zanebeeai/WarRig/self-driving (eBurb POC)/zane_self_driving_car_report.pdf

Making a car, then avoiding driving it.

Zane Beeai

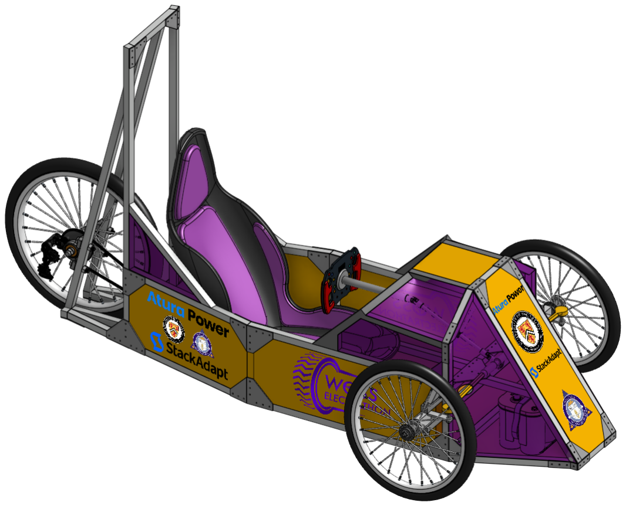
[picture p3: figure]

June 12, 2025

Z. Beeai | Full-scale self-driving EV | June 12, 2025 | 1 / 32

## Outline

1 | Introduction
2 | Frame Design
3 | Front Drivetrain
4 | Rear Drivetrain
5 | Electrical System
6 | Autonomy System
Z. Beeai | Full-scale self-driving EV | June 12, 2025 | 2 / 32

## Our Ethos

Minimalist Engineering: simplicity, manufacturability, robustness. Quantitative modeling: FEA, drivetrain & electrical analysis. Subsystem-based design philosophy.

Z. Beeai | Full-scale self-driving EV | June 12, 2025 | 3 / 32

## Design Objectives

Simplicity Across Subsystems

DFMA for Manual Tools
Subsystem Modularity
Numerical Justification via Simulation Electrical Redundancy (telemetry, safeguards)
Z. Beeai | Full-scale self-driving EV | June 12, 2025 | 4 / 32

## Material Selection

Aluminum offered ˜74% mass reduction compared to steel while maintaining safety margins validated by FEA.

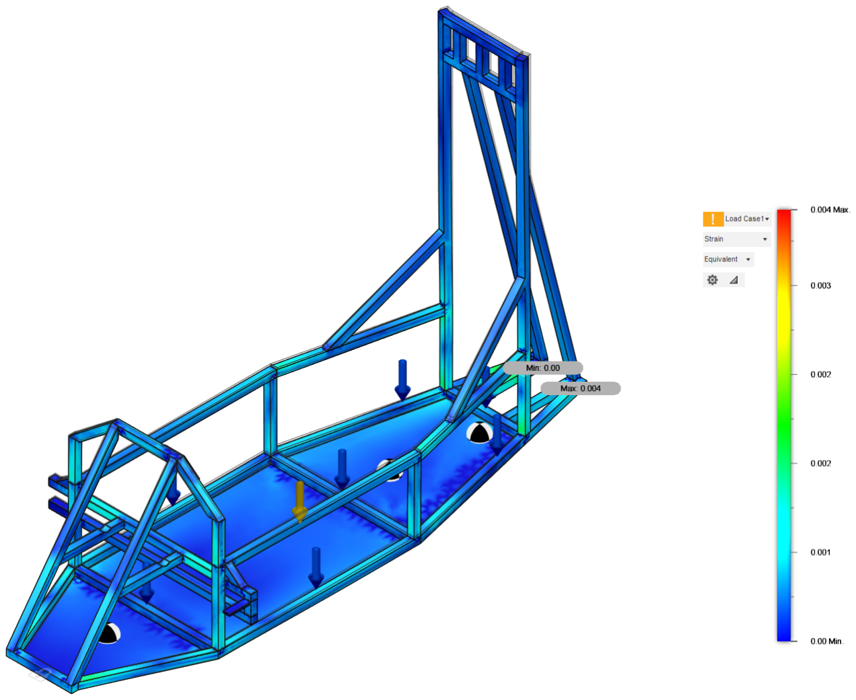
[picture p4: figure]

Figure: Figure 1: Frame FEA under 10,000 N load.

Z. Beeai | Full-scale self-driving EV | June 12, 2025 | 5 / 32

## Hybrid Assembly

Structural gussets combined with bolts, rivets, and TIG welding reinforced load paths at critical junctions.

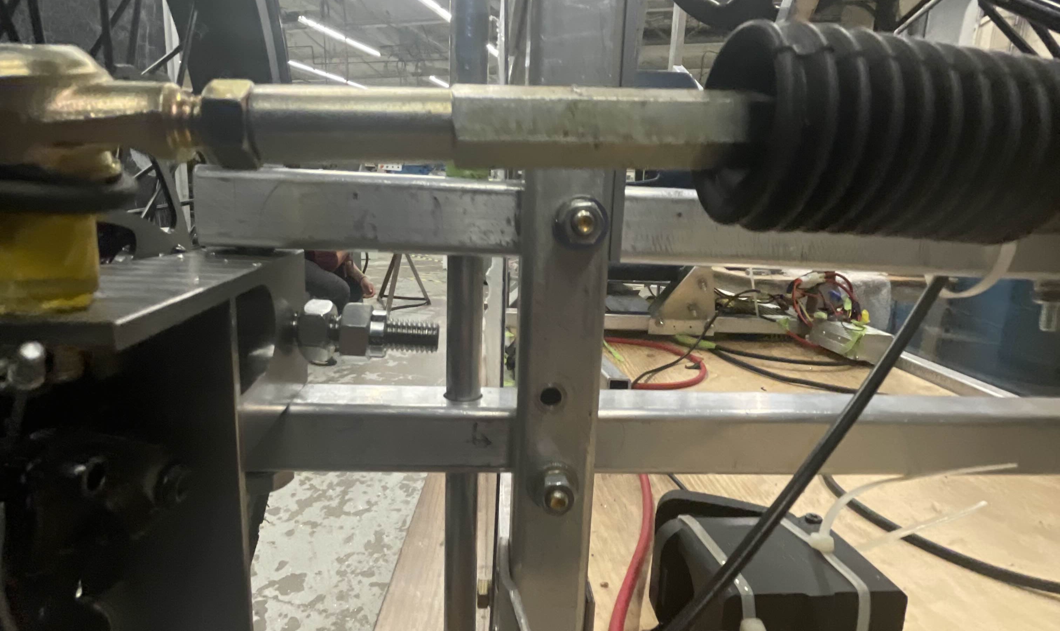
[picture p5: figure]

Figure: Figure 2: Modular clearance mount design for track conditions.

Z. Beeai | Full-scale self-driving EV | June 12, 2025 | 6 / 32

## Load Distribution

Weight placement balanced the longitudinal COM; battery front-loaded to counter motor mass.

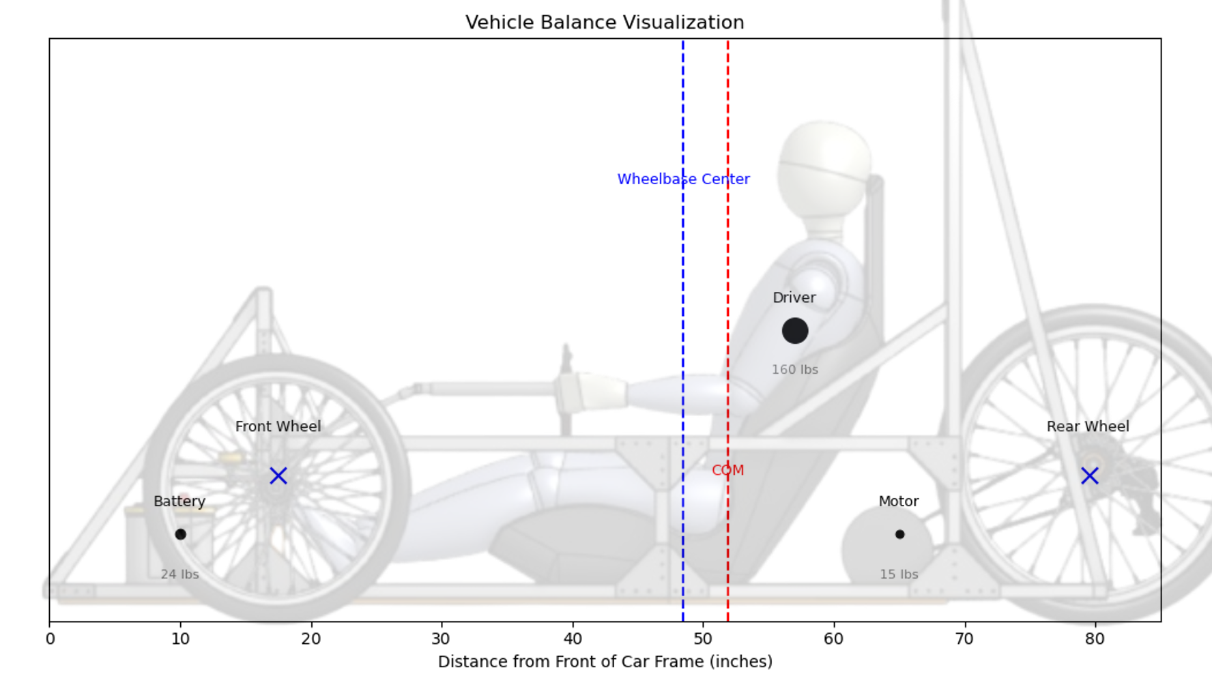
[picture p6: figure]

Figure: Figure 3: Longitudinal mass distribution.

Z. Beeai | Full-scale self-driving EV | June 12, 2025 | 7 / 32

## FEA Validation

Final frame FEA validated design stability at peak race loads.

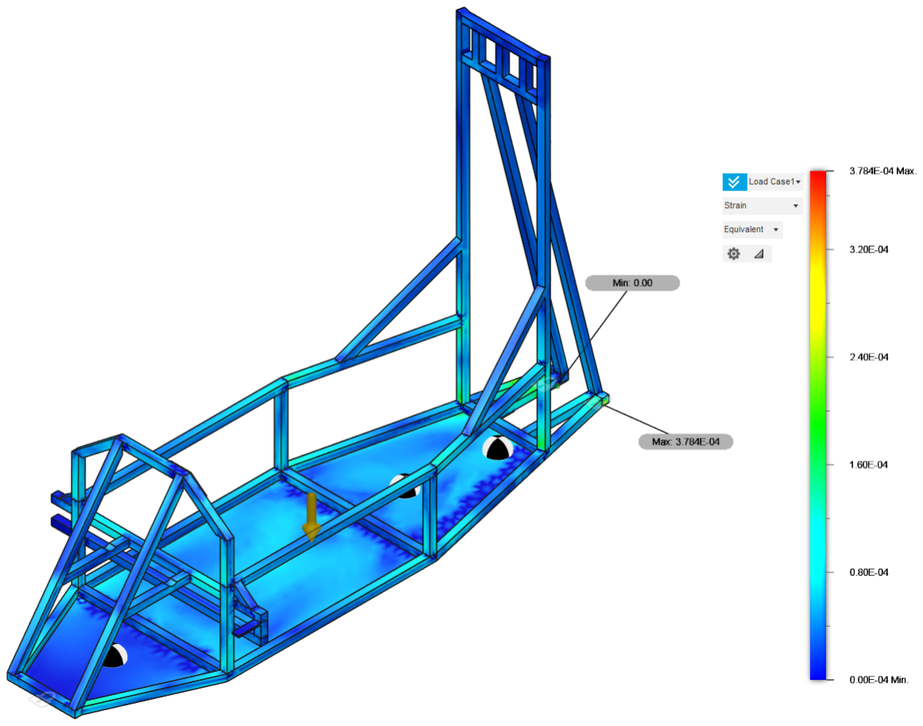
[picture p7: figure]

Figure: Figure 4: Von Mises stress simulation.

Z. Beeai | Full-scale self-driving EV | June 12, 2025 | 8 / 32

## Stress-Strain Analysis

Strain levels remain far within aluminum elastic region.

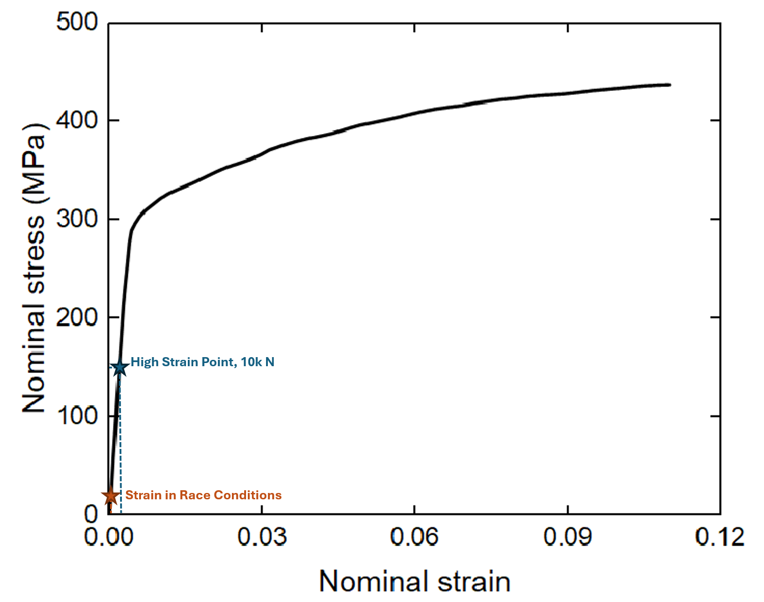
[picture p8: figure]

Figure: Figure 5: 1060 aluminum stress-strain curve with FEA data.

Z. Beeai | Full-scale self-driving EV | June 12, 2025 | 9 / 32

## Spindle Design

Aluminum spindle failed under braking; steel redesign eliminated excessive deflection.

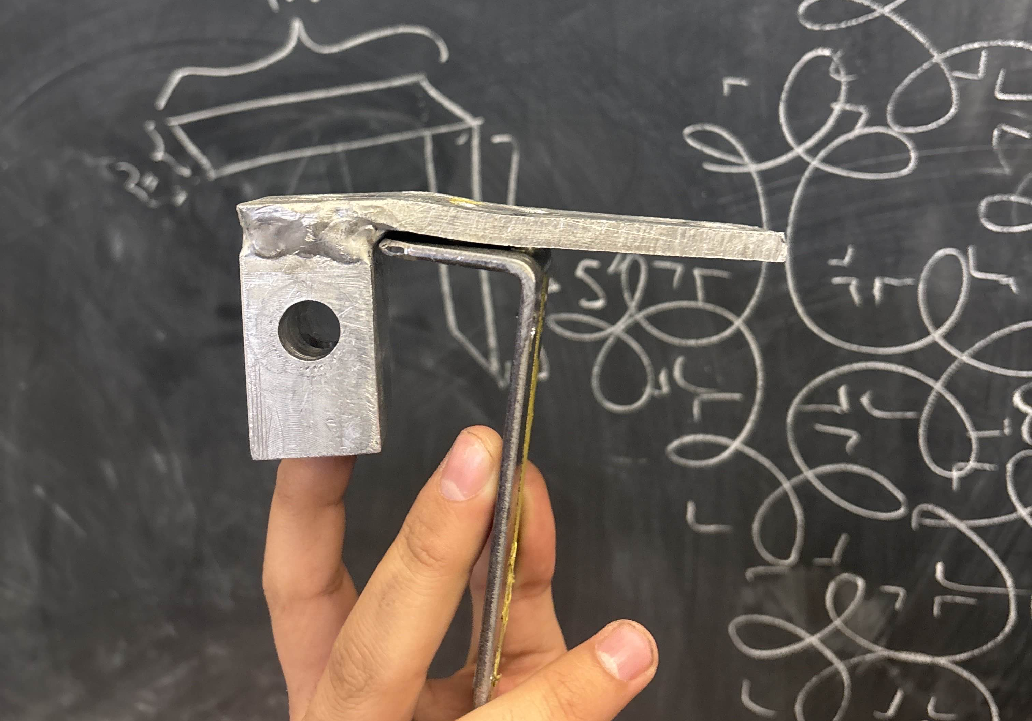
[picture p9: figure]

Figure: Figure 6: Aluminum spindle post-failure.

Z. Beeai | Full-scale self-driving EV | June 12, 2025 | 10 / 32

## Steel Spindle FEA

1045 steel spindle blocks showed minimal strain under braking simulation.

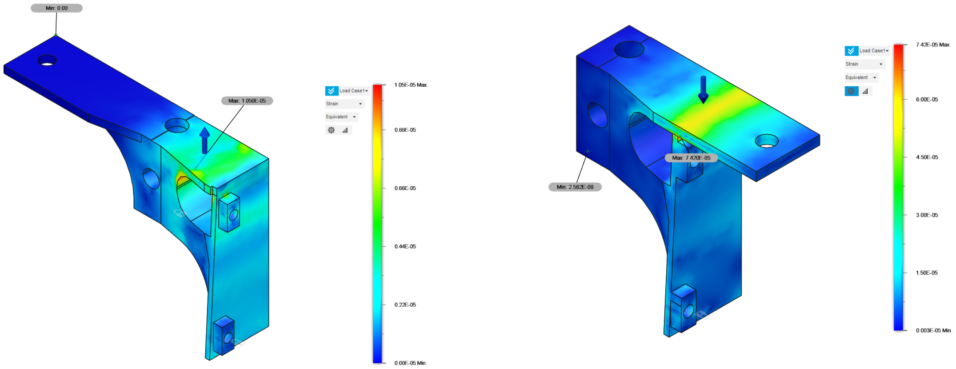
[picture p10: figure]

Figure: Figure 7: FEA strain on steel spindles (left/right).

Z. Beeai | Full-scale self-driving EV | June 12, 2025 | 11 / 32

## Camber Analysis

Lateral grip maximized near −3

◦
camber (Pacejka-based model).

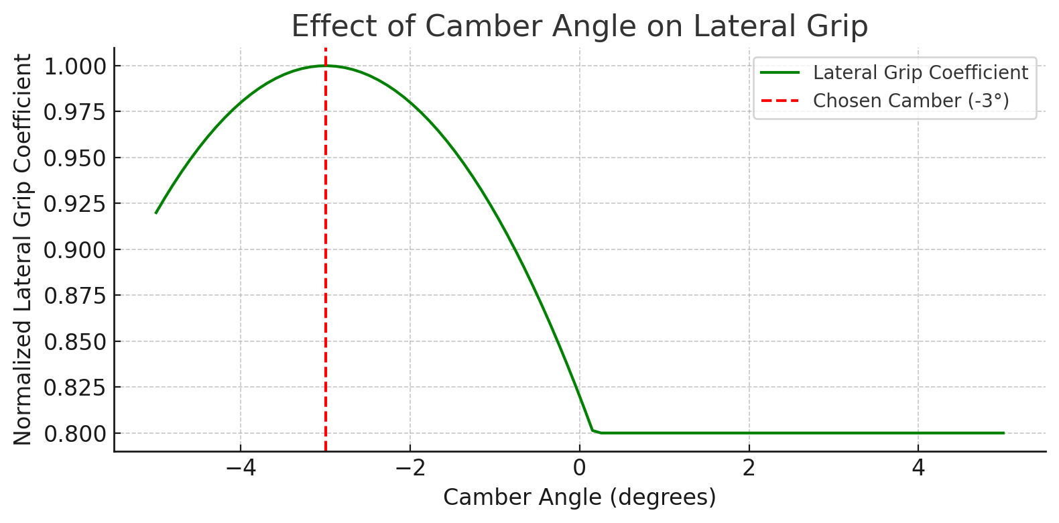
[picture p11: figure]

Figure: Figure 8: Camber vs lateral force.

Z. Beeai | Full-scale self-driving EV | June 12, 2025 | 12 / 32

## Camber Testing

Visual test confirmed −3

◦
camber in real-world driving.

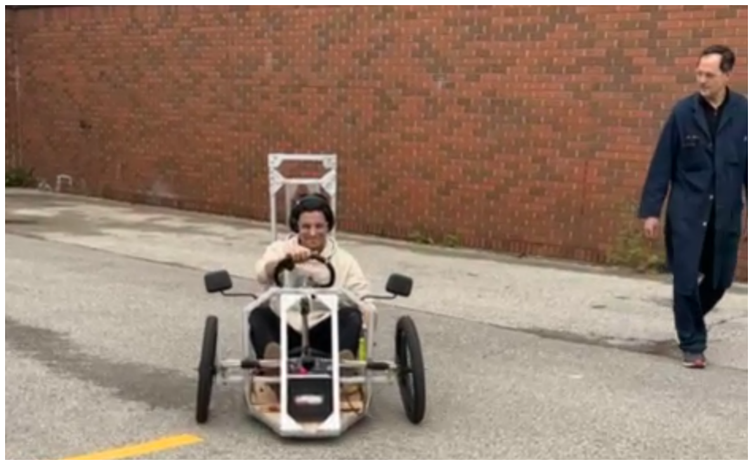
[picture p12: figure]

Figure: Figure 9: Camber confirmation.

Z. Beeai | Full-scale self-driving EV | June 12, 2025 | 13 / 32

## Steering Geometry

Ackermann geometry validated for 2.5m turn radius.

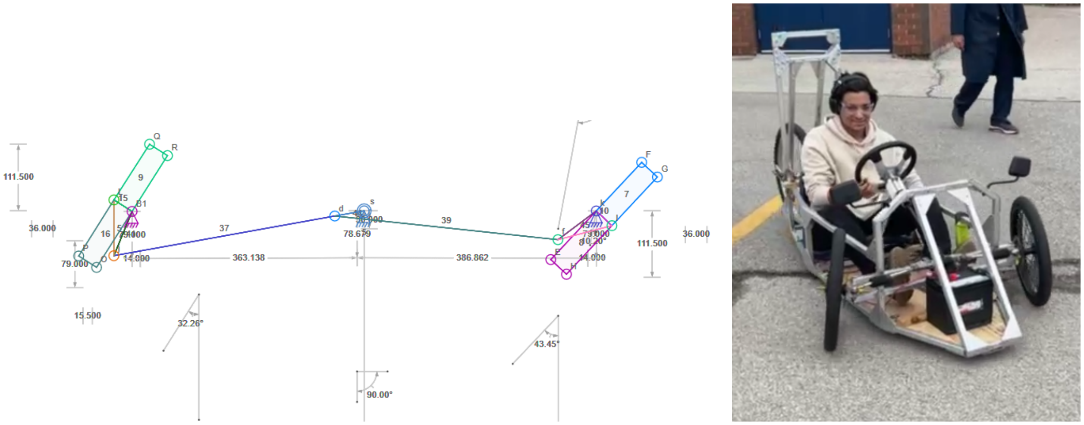
[picture p13: figure]

Figure: Figure 10: CAD projection (left), drive test (right).

Z. Beeai | Full-scale self-driving EV | June 12, 2025 | 14 / 32

## Motor Selection

AmpFlow E30-400-24 provided optimal efficiency at 480W input.

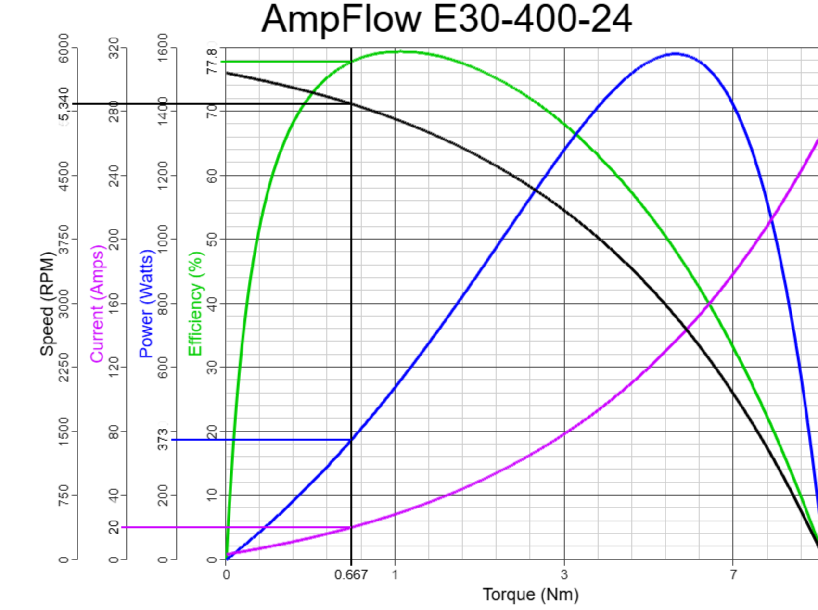
[picture p14: figure]

Figure: Figure 11: AmpFlow motor efficiency curve.

Z. Beeai | Full-scale self-driving EV | June 12, 2025 | 15 / 32

## Custom Gearbox

Custom 81:16 reduction gearbox minimized sprocket friction losses.

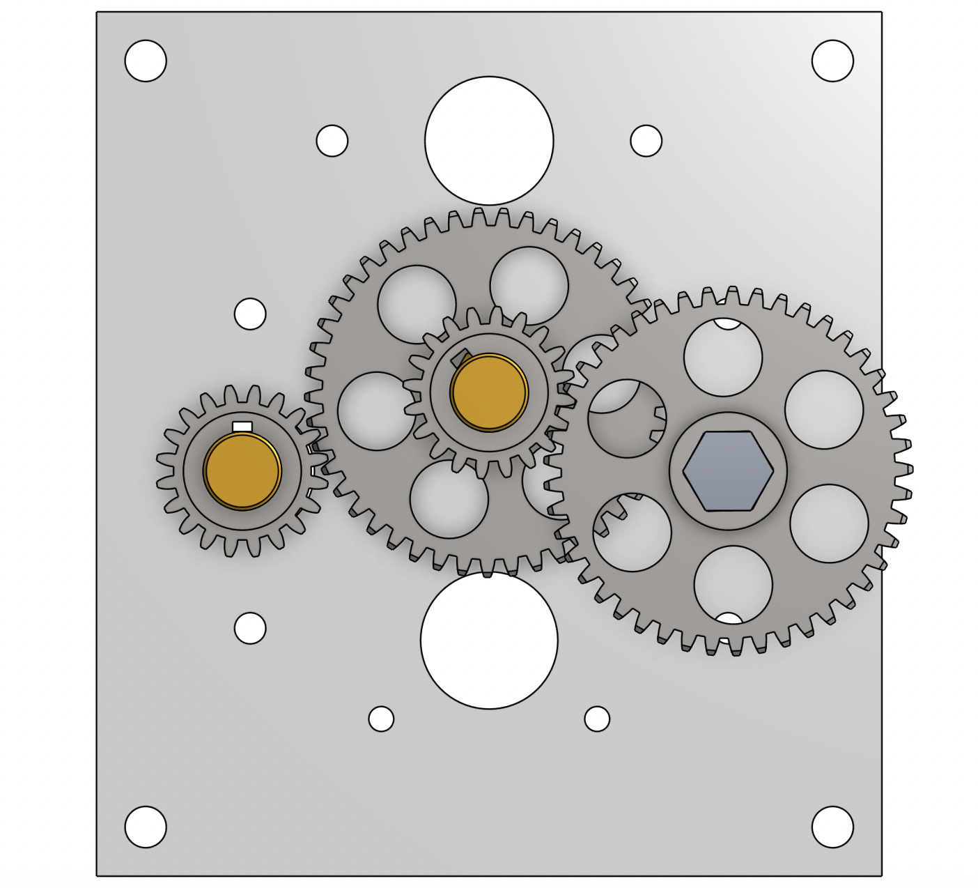
[picture p15: figure]

Figure: Figure 12: Custom gearbox design.

Z. Beeai | Full-scale self-driving EV | June 12, 2025 | 16 / 32

## Chain Stability

Idler-tensioner reduced chain oscillations and derailments.

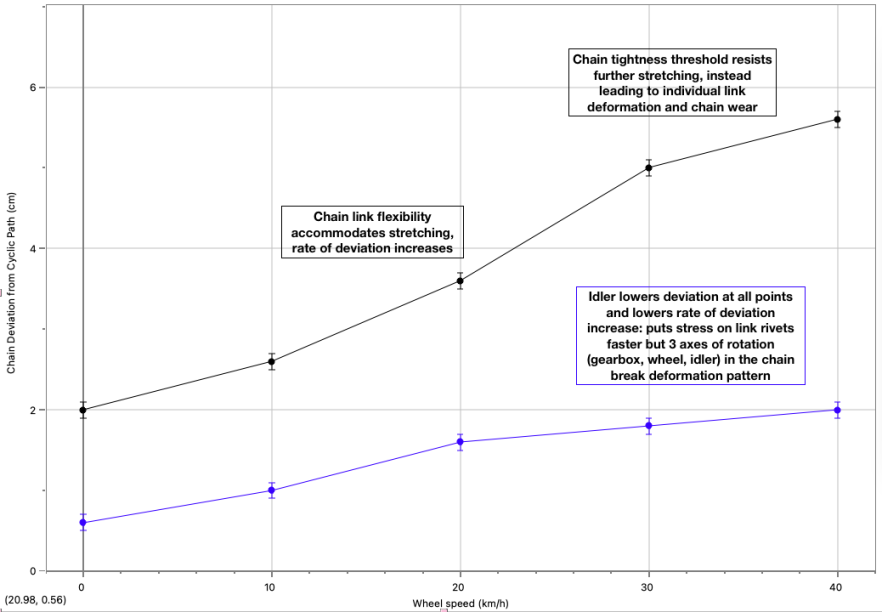
[picture p16: figure]

Figure: Figure 13: Chain deviation before/after idler install.

Z. Beeai | Full-scale self-driving EV | June 12, 2025 | 17 / 32

## Initial Chain Failure

Chain derailed above 20 km/h prior to idler fix.

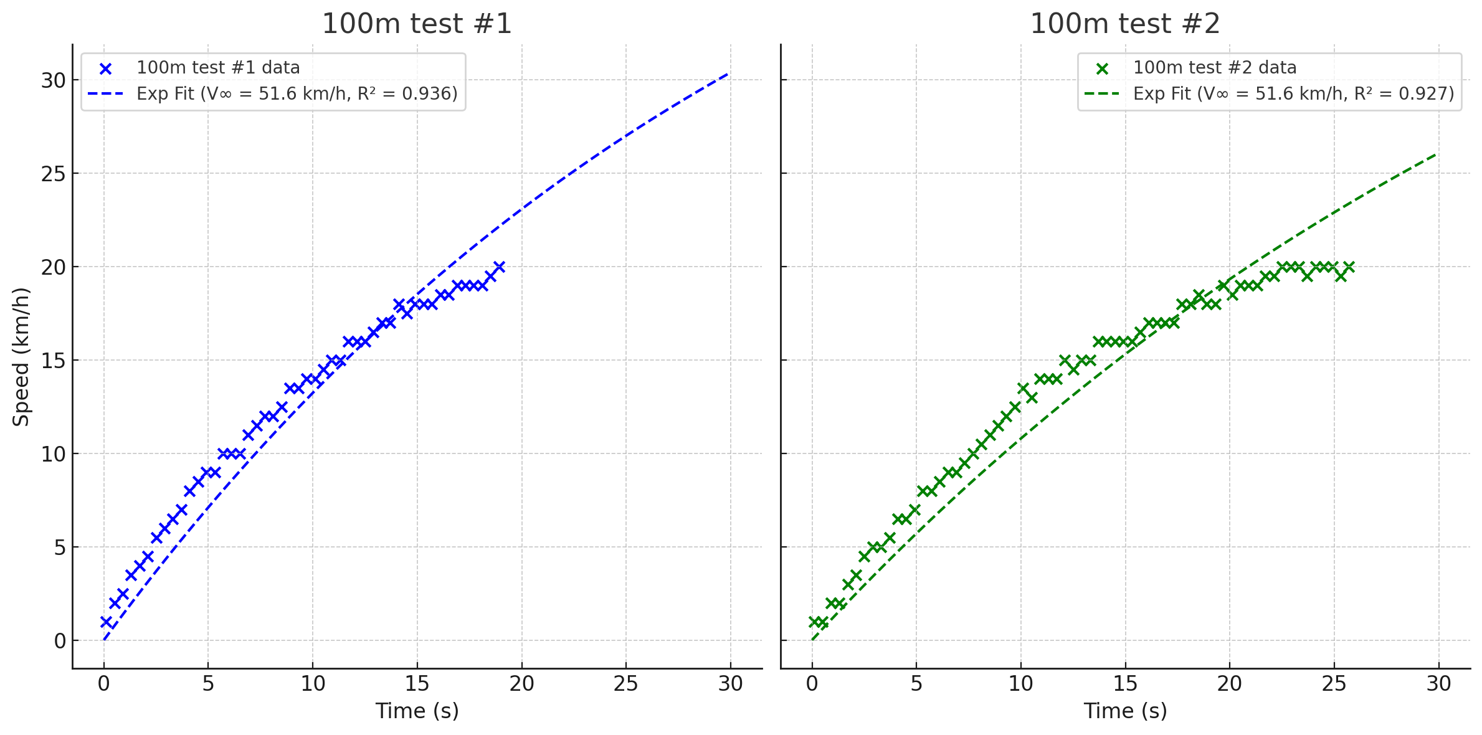
[picture p17: figure]

Figure: Figure 14: Pre-fix chain derailment testing.

Z. Beeai | Full-scale self-driving EV | June 12, 2025 | 18 / 32

## Acceleration After Fix

Post-fix acceleration stabilized drivetrain operation.

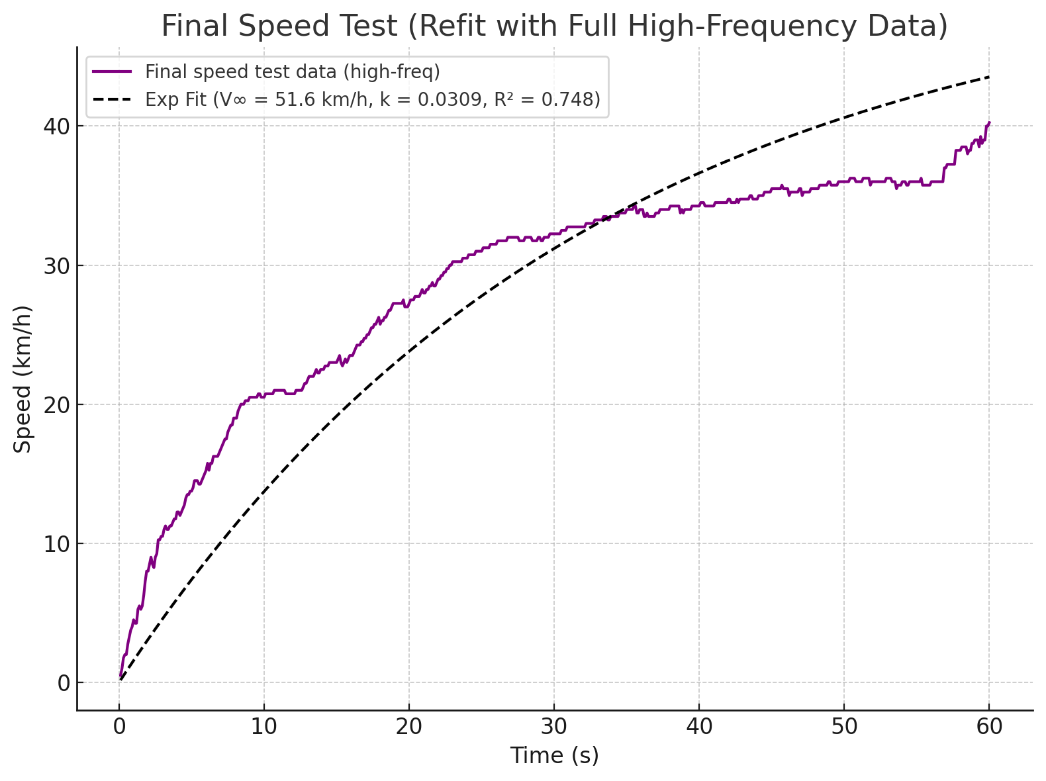
[picture p18: figure]

Figure: Figure 15: Final 0–40 km/h acceleration.

Z. Beeai | Full-scale self-driving EV | June 12, 2025 | 19 / 32

## Powertrain Architecture

Boosted 12V-24V powertrain maximized efficiency and runtime.

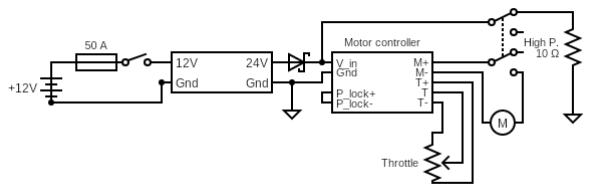
[picture p19: figure]

Figure: Figure 16: Full electrical diagram, before self-driving.

Z. Beeai | Full-scale self-driving EV | June 12, 2025 | 20 / 32

## Self-Driving Overview

Fully custom vision-based steering control (camera-only perception). Integrated mechanical + electrical + ML stack (data → model → actuator).

Three front-mounted 1440p cameras for visual input.
Control loop: Perception → Inference → Actuation.
Z. Beeai | Full-scale self-driving EV | June 12, 2025 | 21 / 32

## Mechanical Integration

Motorized steering via gear-driven actuator mounted to the steering column.
Emergency override kill switch integrated into the main power circuit. Arduino Nano provided the low-level interface between motor controller and main compute.

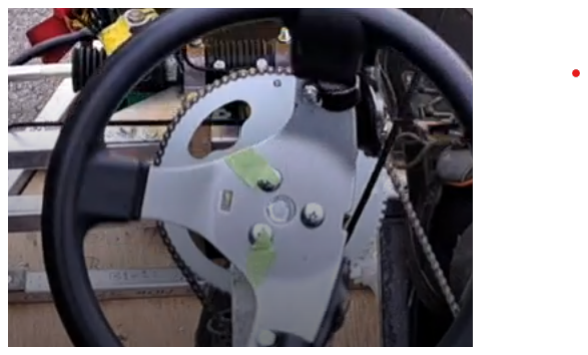
[picture p20: figure]

Figure: Figure 17: Motorized steering assembly.

Z. Beeai | Full-scale self-driving EV | June 12, 2025 | 22 / 32

## Hardware Data Flow

3× 1440p cameras mounted on the front hood.

USB 3.0 capture to a local compute node.
Inference computed onboard (CPU/GPU depending on configuration).

Arduino Nano converts the commanded steering signal to PWM for the steering actuator.

Z. Beeai | Full-scale self-driving EV | June 12, 2025 | 23 / 32

## Machine Learning Pipeline

Dataset generation: manual driving recorded with synchronized images and steering command (label).
Supervised training on the collected dataset (regression).

Final model: neural network predicting a continuous steering command θ.
Software stack: OpenCV, TensorFlow/Keras, Python.
Z. Beeai | Full-scale self-driving EV | June 12, 2025 | 24 / 32

## Computer Vision Preprocessing

OpenCV preprocessing used to reduce visual complexity and emphasize lane structure:
Edge detection (Canny).
Line proposals via HoughLines (optional, for visualization/debugging). Perspective transform to a bird’s-eye view (consistent road geometry). Output: a compact feature representation (e.g., edge map / warped frame) used as network input.

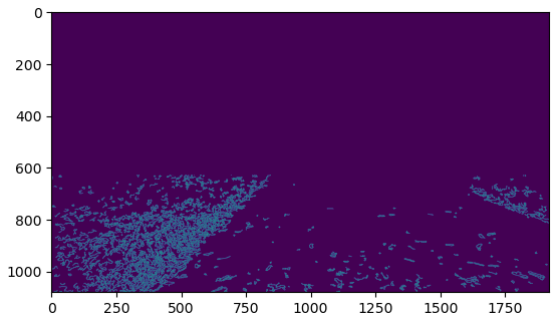
[picture p21: figure]

Figure: Figure 19: Sample edge map from preprocessing.

Z. Beeai | Full-scale self-driving EV | June 12, 2025 | 25 / 32

## Neural Network Architecture

Convolutional regression network for behavioral cloning (image → steering).
Layers:
Convolution + ReLU + MaxPool × 3
Fully connected layers
Single output node: predicted steering command θ
Inspired by end-to-end driving architectures (CNN-based steering regression).
θ = f (image input)
Z. Beeai | Full-scale self-driving EV | June 12, 2025 | 26 / 32

## Pipeline Validation (MNIST)

MNIST was used only to validate the training codepath (dataloader → model → loss → optimizer).

Confirmed that training converged and that inference ran correctly on the target compute.
The driving model was trained on the collected driving dataset (not MNIST).
Z. Beeai | Full-scale self-driving EV | June 12, 2025 | 27 / 32

## Behavioral Cloning in Application

Trained network produced stable steering on the target track conditions represented in the dataset.
Smooth steering response on both turns and straights after output filtering (deadband / rate limiting).
Inference latency: < 50 ms (compute only; actuator response is higher).

Video Reference: Self-Driving Turn Clip.

Z. Beeai | Full-scale self-driving EV | June 12, 2025 | 28 / 32

## Sample Control Output

Network predicts steering command θ each frame (or at a fixed control rate).
Post-processing for stability:
deadband to suppress small prediction noise
saturation to bound maximum steering command
optional rate limiting to avoid abrupt steps
Arduino maps the commanded steering signal to PWM for the actuator.
PWM = a · θ + b
Z. Beeai | Full-scale self-driving EV | June 12, 2025 | 29 / 32

## Closed-Loop Steering (if angle feedback is available)

Network outputs θdesired (desired steering angle/command).

If a steering angle sensor is available, a feedback controller corrects actuator error:

e(t) = θdesired(t) − θmeasured(t)

PWM(t) = KPe(t) + KI

Z t

0

e(τ ) dτ + KD

de(t)
dt + b

Baseline offset b centers the PWM range.

PID reduces steady-state error and smooths transient response under disturbances/load changes.

If no angle sensor is present, the system operates open-loop with saturation + rate limiting (no θmeasured term).

Z. Beeai | Full-scale self-driving EV | June 12, 2025 | 30 / 32

## Real-World Performance

Stable control maintained through a straight track segment. Self-driving completed both straight and curved segments under the tested conditions.
Kill-switch handover available in case of system faults.
Video Reference: Self-Driving Straight Clip.
Z. Beeai | Full-scale self-driving EV | June 12, 2025 | 31 / 32

# Thank You!

Z. Beeai | Full-scale self-driving EV | June 12, 2025 | 32 / 32
